formatc1702/bluetooth-minidisc/(commit log)

2021-05-13 Add v0.2 schematic
2021-05-22 Add basic firmware for auto-power-on
2021-05-22 Add sleep after auto-power-on
2023-01-27 Add schematic drawings
2023-01-27 Add images for pinouts and trace cuts
2023-01-27 Fix schematic
